dtmirizzi/Tesla-Model-3-Drive-Unit/ato/README.md

# M3DU logic board in atopile

An [atopile](https://atopile.io) port of the V3.2 logic board in
`../Design/M3DU_BoardV3_2`. It is the same board, checked pad by pad: the same
798 parts, designators, nets, BOM and hand-routed layout. It is organised into
modules, one per block of the schematic, and the three gate-driver phases share
one `GateDrivePhase` module. See [PLAN.md](PLAN.md) for details and next steps.

## Layout

```
ato.yaml                 atopile project (requires atopile ^0.15.9)
main.ato                 module M3DU: the blocks, power rails and nets between blocks
src/                     one module per schematic block (power/, gate_drive/, sensing/, ...)
parts/<KiCadLib>/        one atopile component per BOM line + its footprint/symbol
layouts/default/         the KiCad board atopile builds into (seeded from the original PCB)
lib/                     footprint + symbol libraries recovered from the KiCad design
reference/netlist.json   reference netlist extracted from the original PCB
reference/addresses.json designator -> atopile address (binds the layout)
tools/                   extraction, code generation, layout seeding and the equivalence check
```

## Build

```bash
uv venv -p 3.14 .venv && . .venv/bin/activate
uv pip install atopile==0.15.9 pandas xlrd

tools/port.sh            # extract -> generate -> seed layout -> ato build -> check
# or, once seeded:
ato build --no-standardize-designators
python tools/restore_layout.py  # put back attributes atopile 0.15.9 drops
python tools/check_netlist.py   # board vs KiCad V3.2: nets + layout
python tools/check_bom.py       # BOM vs the V3.2 JLC BOM
```

`main.ato`, `src/` and `parts/` are generated by `tools/gen_modules.py` (set
`FLAT=1` for a single flat module). The board stays bound to the layout through
the original designators.

`check_netlist.py` exits non-zero unless the built board matches the original:
the same references and pad geometry, the same pad-to-net partition, and every
footprint, track, via and zone in place.

Open `layouts/default/default.kicad_pcb` in KiCad 9 to view or edit the board.
After editing the layout, run `tools/port.sh --no-seed` so your edits are kept.
For now the original KiCad project is still the source of truth: `tools/port.sh`
and CI regenerate everything from it.
