dtmirizzi/Tesla-Model-3-Drive-Unit/ato/layouts/default/default.kicad_pcb

## KiCad design ato/layouts/default/default.kicad_pcb (2026-11-04)

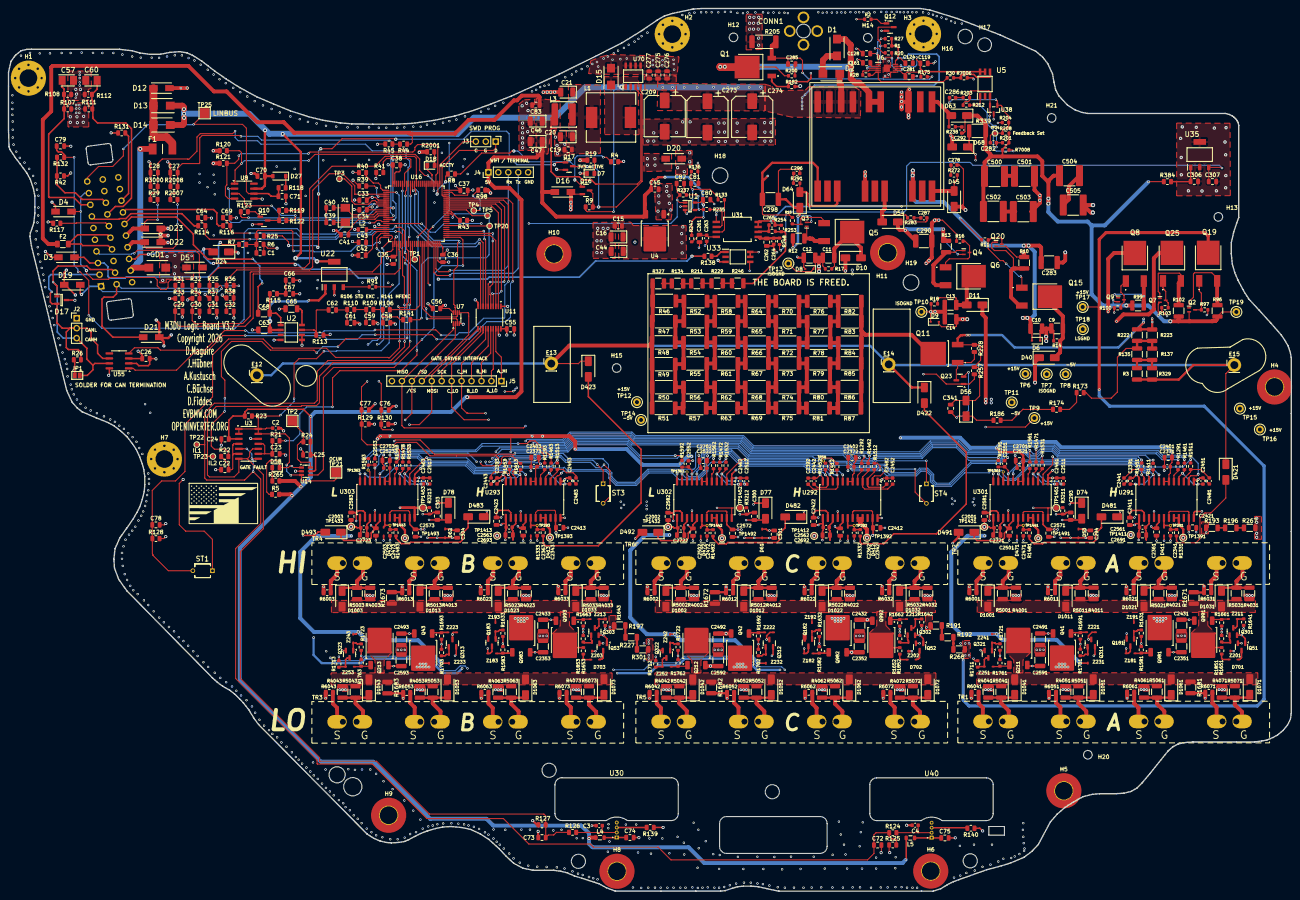
[picture p1: board default.kicad_pcb from above]

Board: 4 copper layers, 327.6 x 225.4 mm, 797 parts (1 on the bottom side), 394 nets.

Parts:
C1, C306: 1uF; C_0805_2012Metric__v3
C2: 10nF; C_0603_1608Metric__v3
C3, C4, C265: 10nF; C_0603_1608Metric
C9, C10, C11, C12, C13, C14: 2.2uF; C_1210_3225Metric
C15, C19, C22, C24, C25, C27, C28, C34, C35, C36, C56, C70: 1uF; C_0805_2012Metric__v2
C16, C20, C21, C44: 100uF 6.3V; CP_EIA-3528-15_AVX-H__v2
C23, C29, C30, C31, C32, C37, C38, C45, C55, C74, C75, C76, C77, C78, C79, C80, C119, C276, C277, C301, C304, C341, C2361, C2362, C2363, C2411, C2412, C2413, C2421, C2422, C2423, C2501, C2502, C2503, C2571, C2572, C2573, C2581: 1uF; C_0805_2012Metric
C26, C41, C42: 100nF; C_0805_2012Metric
C33, C43, C261: 10uF; C_0805_2012Metric
C39, C40: 22pF; C_0805_2012Metric
C46, C47: 100uF 6.3V; CP_EIA-3528-15_AVX-H
C57: 100uF 6.3V; CAPPM3528X210N
C58, C59, C61, C66, C67: 22nF; C_0805_2012Metric
C60: 100uF 6.3V; CAPPM3528X210N__v2
C62: 22nF; C_0805_2012Metric__v2
C63, C65: 10uF; C_1206_3216Metric__v2
C64, C69, C71, C72: 1nF; C_0805_2012Metric
C68: 10uF; C_1206_3216Metric
C73: 1nF; C_0805_2012Metric__v2
C81, C82: 100pF; C_0805_2012Metric
C83: 1nF; C_0805_2012Metric__v4
C124, C275: 0.1uF; C_0805_2012Metric
C128: 200pF; C_0805_2012Metric
C161: 47nF; C_0805_2012Metric
C209: 100uF 25V; CP_Elec_10x10
C262: 10uF; C_0805_2012Metric__v2
C263, C2001, C2002, C2003, C2371, C2372, C2373, C2521, C2522, C2523, C2561, C2562, C2563: 100nF; C_0603_1608Metric
C264: 100nF; C_0603_1608Metric__v2
C273, C274: 220uF 35V; CP_Elec_10x10
C278, C287, C292, C296, C2341, C2342, C2343, C2471, C2472, C2473: 82pF; C_0603_1608Metric
C281: 330pF; C_0805_2012Metric
C282: 10nF; C_0603_1608Metric__v2
C283, C290, C298: 3.3uF; C_1812_4532Metric
C285: 470pF; C_0805_2012Metric
C286: 22nF; C_0603_1608Metric__v2
C293, C294, C300, C303, C2582, C2583: 2.2uF; C_0805_2012Metric
C307: 10uF; C_0805_2012Metric__v3
C500, C501, C502, C503, C504, C505: 15uF; C_2220_5750Metric
C2351, C2352, C2353, C2431, C2432, C2433, C2491, C2492, C2493, C2591, C2592, C2593: 4.7uF; C_1210_3225Metric
C2391, C2392, C2393, C2451, C2452, C2453, C2461, C2462, C2463, C2481, C2482, C2483, C2511, C2512, C2513, C2551, C2552, C2553: 82pF; C_0603_1608Metric__v2
C2401, C2402, C2403, C2691, C2692, C2693, C2701, C2702, C2703, C2721, C2722, C2723: 4.7uF; C_0805_2012Metric
C2441, C2442, C2443: 470pF; C_0603_1608Metric__v2
CONN1: HV_Hvil; HV_HVIL
D1: 1N5819; DIOM5336X244N__v2
D2: 1N5935B; DIOM5336X244N__v2
D3, D4, D5, D19: SMAJ18CA; DIOM5127X229N
D6, D8: 5V1; D_SOD-323__v2
D7: 3V3 LED; LED_0805_2012Metric
D9: 5V1; D_SOD-323
D10, D40: SS35; D_SMA__v2
D11: SS35; D_SMA
D12: SMAJ18CA; DIONM5127X229N
D13, D14: SS54B; DIOM5336X244N
D15: SS54B; DIOM5336X244N__v2
D16, D22, D23: SMAJ7.0A; DIOM5026X229N
D17: ESDCAN01-2BLY; SOT95P255X150-3N
D18: LED; LED_0805_2012Metric
D20: SMAJ7.0A; DIOM5026X229N__v2
D21: SMAJ18CA; DIOM5127X229N__v2
D24: SMAJ18CA; D_SMA__v3
D27: 1N4148W; D_SOD-123
D45, D64: STPS2H100-Y; D_SMA__v2
D53, D61, D62: G1; D_SOD-323__v3
D54, D63: STPS2H100-Y; D_SMA
D56: 15V; D_SMA__v4
D58: LED; LED_0805_2012Metric__v2
D68: Zener 5V1; D_SMA
D74, D77, D78, D421, D422, D423: VN17; D_SMA
D411, D412, D413, D701, D702, D703: JV; D_SOD-323
D471, D472, D473: JV; D_SOD-323__v3
D481, D482, D483, D491, D492, D493: VN17; D_SMA__v2
D1001, D1002, D1003, D1011, D1012, D1013, D1021, D1022, D1023, D1031, D1032, D1033, D1041, D1042, D1043, D1051, D1052, D1053, D1061, D1062, D1063, D1071, D1072, D1073: 2H2; D_SMA
E12, E13, E14, E15: HV+; M3_HVPOS
F1: JFC2410-0500TS; FUSC6126X280N
F2: 1206L050/24WR; Fuse_1206_3216Metric
GD1: 2051-09-SM-RPLF; DIOM5336X244N
H1, H2, H3, H7: MountingHole_Pad; MountingHole_4.5mm_Pad_Via
H4, H5, H6, H8, H9, H10, H11: MountingHole_Pad; MountingHole_4.5mm_Pad_TopBottom
H12, H14, H15, H21: MountingHole; MountingHole_2.2mm_M2__v2
H13: MountingHole; MountingHole_2.2mm_M2__v3
H16: MountingHole; MountingHole_3.7mm
H17: MountingHole; MountingHole_3.5mm
H18, H19: MountingHole; MountingHole_4mm
H20: MountingHole; MountingHole_2.2mm_M2
J1: Conn_01x30_Male; M3DU_MAINCONN
J2: CAN MON; PinHeader_1x03_P2.54mm_Vertical
J3: M032.54MM; PinHeader_1x03_P2.54mm_Vertical
J4: WiFi Serial Interface; PinHeader_1x05_P2.54mm_Vertical
J5: Conn_01x12_Socket; PinSocket_1x12_P2.54mm_Vertical
JP1: SolderJumper_2_Open; SolderJumper-2_P1.3mm_Open_Pad1.0x1.5mm
L1: 68uH; L_12x12mm_H8mm
L2, L4, L5: 10uH; L_0805_2012Metric
L3: 3uH; L_APV_ANR6020
Q1: IPD50N06S409ATMA2
Q2, Q3, Q4, Q7, Q9, Q20: BC857BT-7-F; SOT50P160X90-3N
Q5, Q6, Q15: NJVMJD127T4G; NVD5117PLT4GVF01__v2
Q8, Q19, Q25: NJVMJD127T4G; NVD5117PLT4GVF01
Q10, Q12: MMBT3904; SOT-23
Q11: FGD3N60LSDTM
Q16, Q17: MMBT3904; SOT-23__v3
Q23: BSS84W; SOT-23__v2
Q41, Q42, Q43, Q981, Q982, Q983: 45P4LLF6; TO-252-2
Q51, Q52, Q53: SG NMOS D; SOT-23
Q181, Q182, Q183: BSS84AK; SOT-23__v2
Q211, Q212, Q213, Q991, Q992, Q993: 3N0408; TO-252-2
Q301, Q302, Q303: BSS138BK; SOT-23__v2
Q311, Q312, Q313: BSS84AK; SOT-23
Q321, Q322, Q323: BSS138BK; SOT-23
R1, R133, R136, R235, R237: 10K; R_0603_1608Metric
R2: 3K3; R_0603_1608Metric
R3, R135, R137, R222, R223, R329: 82K; R_1210_3225Metric
R4: 10K; R_0805_2012Metric__v6
R5: 10K; R_0805_2012Metric__v9
R6: 1K5; R_0805_2012Metric__v3
R7: 4K7; R_0805_2012Metric__v3
R8, R25: 10K; R_0805_2012Metric__v3
R9: 27K; R_0805_2012Metric__v4
R10, R13, R99: 4R99; R_1210_3225Metric
R11, R16, R97, R100, R103: 22K; R_0603_1608Metric
R12, R96, R102: 4R99; R_1210_3225Metric__v2
R14, R17, R18: 4K7; R_0603_1608Metric
R15: 22K; R_0603_1608Metric__v2
R19: 680R; R_0805_2012Metric__v2
R20: 4R7; R_0603_1608Metric
R21, R22, R113, R114, R115, R116, R119, R128, R129, R130: 10K; R_0805_2012Metric__v2
R23, R24, R31, R32, R35, R36, R41: 4K7; R_0805_2012Metric__v2
R26: 120R; R_0805_2012Metric__v2
R27: 300K; R_0603_1608Metric
R28: 33.2K; R_0603_1608Metric__v2
R29, R39, R40, R43, R118, R123, R131, R132, R265, R2007, R2008, R3000: 1K; R_0805_2012Metric__v2
R30: 18K; R_0603_1608Metric
R33, R34, R37, R38: 1K5; R_0805_2012Metric__v2
R42, R44: 47K; R_0805_2012Metric__v2
R45, R122: 3K3; R_0805_2012Metric__v2
R46, R51, R56, R61, R66, R71, R76, R81, R82, R83, R84, R85, R86, R87: 3K9; R_2512_6332Metric
R47, R48, R49, R50, R52, R53, R54, R55, R57, R58, R59, R60, R62, R63, R64, R65, R67, R68, R69, R70, R72, R73, R74, R75, R77, R78, R79, R80: 3K9; R_2512_6332Metric__v2
R91: 1K; R_0603_1608Metric
R98: 1K; R_0805_2012Metric__v3
R106: 3K9; R_0805_2012Metric__v7
R107, R108, R112: 220R; R_0805_2012Metric__v2
R109, R110: 1K8; R_0805_2012Metric__v2
R111: 220R; R_0805_2012Metric
R117: 0R; R_0805_2012Metric__v2
R120, R121, R138: 2K2; R_0805_2012Metric__v2
R124, R126: 3K6; R_0805_2012Metric__v2
R125, R127: 6K2; R_0805_2012Metric__v2
R134, R211, R229, R246, R327: 75K; R_1210_3225Metric
R139, R140: 10k; R_0805_2012Metric__v5
R141: 3K9; R_0805_2012Metric__v8
R173, R174, R186: 50K; R_0805_2012Metric__v4
R175, R1331, R1332, R1333, R1411, R1412, R1413, R1461, R1462, R1463, R1471, R1472, R1473, R1481, R1482, R1483, R7006: 1k; R_0603_1608Metric
R182: 100K; R_0603_1608Metric__v2
R191, R192, R193, R196, R197, R227, R267, R268, R301: 1M; R_1206_3216Metric
R200: 20R; R_0603_1608Metric__v2
R201: 35K6; R_0603_1608Metric
R203, R212: 25K; R_0603_1608Metric
R204: 5K6; R_0603_1608Metric
R205: 0.01R; R_2512_6332Metric_Pad1.40x3.35mm_HandSolder
R208: 39K; R_0603_1608Metric
R228, R257: 100K; R_0805_2012Metric__v2
R238: 80.6R; R_0603_1608Metric__v2
R247, R248: 10R; R_0603_1608Metric
R253: 39R; R_0603_1608Metric
R254: 1K6; R_0603_1608Metric
R272, R283, R291: 80.6R; R_0603_1608Metric
R339: 4K7; R_1812_4532Metric
R384: 0R; R_0805_2012Metric__v4
R1291, R1292, R1293, R1561, R1562, R1563: 680; R_0603_1608Metric
R1451, R1452, R1453, R1511, R1512, R1513, R1531, R1532, R1533, R1641, R1642, R1643, R1711, R1712, R1713: 100; R_0603_1608Metric
R1581, R1582, R1583, R1631, R1632, R1633, R1651, R1652, R1661, R1662, R1663, R1691, R1692, R1693, R1701, R1702, R1703, R1761, R1762, R1763, R1853: 27K; R_0603_1608Metric
R1591, R1592, R1593: 200; R_0603_1608Metric
R1653, R1851, R1852: 470; R_0603_1608Metric
R1671, R1672, R1673: 4K7; R_1210_3225Metric__v2
R1681, R1682, R1683: 4K7; R_1210_3225Metric
R1721, R1722, R1723: 27K; R_0603_1608Metric__v3
R2001: 330R; R_0805_2012Metric__v2
R3211, R3212, R3213: 0R; R_0603_1608Metric
R4001, R4002, R4003, R4011, R4012, R4013, R4021, R4022, R4023, R4031, R4032, R4033, R4041, R4042, R4043, R4051, R4052, R4053, R4061, R4062, R4063, R4071, R4072, R4073: 12; R_1210_3225Metric
R5001, R5002, R5003, R5011, R5012, R5013, R5021, R5022, R5023, R5031, R5032, R5033, R5041, R5042, R5043, R5051, R5052, R5053, R5061, R5062, R5063, R5071, R5072, R5073: 10; R_1210_3225Metric
R6001, R6002, R6003, R6011, R6012, R6013, R6021, R6022, R6023, R6031, R6032, R6033, R6041, R6042, R6043, R6051, R6052, R6053, R6061, R6062, R6063, R6071, R6072, R6073: 0.56R; R_0805_2012Metric
R7008: 2K; R_0603_1608Metric
ST1, ST3, ST4: Thermistor; B59100C0140A070
T1: TDK_VGT; VGT22EPC-200S6A12
TP1, TP3, TP4, TP5, TP22, TP23, TP24: TestPoint; TestPoint_Pad_D1.0mm
TP2, TP21, TP25: TestPoint; TestPoint_Pad_2.5x2.5mm
TP6, TP7, TP8, TP9, TP11, TP12, TP13, TP14, TP15, TP16, TP17, TP18, TP19: TestPoint; TestPoint_Keystone_5000-5004_Miniature
TP10: GND_ISO_C; TestPoint_Keystone_5000-5004_Miniature
TP20: TestPoint_Pad_D1.0mm
TP58, TP291, TP292, TP293, TP1361, TP1362, TP1363, TP1441, TP1442, TP1443: TestPoint; TestPoint_Via
TP1391, TP1392, TP1393, TP1411, TP1412, TP1413, TP1431, TP1432, TP1433, TP1451, TP1452, TP1453, TP1491, TP1492, TP1493: TestPoint; TestPoint_Pad_D1.5mm
TR1, TR2, TR3, TR4, TR5: M3DU_MOSFETS; M3DU_Mosfets
TR6: CH1234; M3DU_Mosfets
U1: OPA320AIDBVR; SOT95P280X145-5N
U2: TDA2822D013TR; SOIC127P600X175-8N
U3: LM2901; SOIC-14_3.9x8.7mm_P1.27mm
U4: LD1086DT33TR; TO-252-2
U5, U33: ACPL-M49T-000E; SOIC127P700X260-6N
U6: TPS40210DGQR; SOP50P490X110-11N
U7: 74LVC3G17; VSSOP-8_2.3x2mm_P0.5mm
U8: TJA1021T; SOIC-8_3.9x4.9mm_P1.27mm
U11: SN74LVC245APW; TSSOP-20_4.4x6.5mm_P0.65mm
U14: 74LVC1G10; SOT-23-6
U16: STM32F103VCTx; LQFP-100_14x14mm_P0.5mm
U22: NCV8452STT3G; SOT230P700X180-4N__v2
U30, U40: MLX91209LVA-CAA-000-SP; SIP_4L_VA
U31: ACPL-C87A; SSO-8_6.8x5.9mm_P1.27mm_Clearance8mm
U35: TLE4264G; SOT230P700X180-4N
U38: TL432AQDBZRQ1; SOT95P237X112-3N
U55: SN65HVD230; SOIC-8_3.9x4.9mm_P1.27mm__v2
U70: XL1509-5.0E1; SOIC127P600X175-8N
U291, U302: STGAP1AS; SOIC-24W_7.5x15.4mm_P1.27mm
U292: STGAP1AS; SOIC-24W_7.5x15.4mm_P1.27mm__v2
U293, U301, U303: STGAP1AS; SOIC-24W_7.5x15.4mm_P1.27mm__v3
X1: X50328MSB2GI; Crystal_SMD_5032-2Pin_5.0x3.2mm
Z181, Z182, Z183, Z201, Z202, Z203, Z211, Z212, Z213, Z221, Z222, Z223, Z251, Z252, Z253: 8.2V; D_SOD-323
Z191, Z192, Z193, Z241, Z242, Z243: 8.2V; D_SOD-323__v3
Z231, Z232, Z233: 8.2V; D_SOD-323__v2

Connections:
+3.3VA: C42.2, C43.2, L2.2, U16.21, U16.22
+3V3: C15.1, C16.1, C26.1, C33.2, C34.1, C35.1, C36.1, C37.1, C38.1, C44.1, C55.1, C56.1, C2371.2, C2372.2, C2373.2, C2401.2, C2402.2, C2403.2, C2521.2, C2522.2, C2523.2, C2701.2, C2702.2, C2703.2, D20.1, L2.1, R19.1, R39.1, R40.1, R43.1, R98.1, R107.2, R111.2, R120.1, R121.1, R131.1, R2001.1, ST1.1, ST3.1, ST4.1, U4.2, U7.8, U11.1, U11.20, U16.6, U16.11, U16.28, U16.50, U16.75, U16.100, U55.3, U291.6, U291.7, U292.6, U292.7, U293.6, U293.7, U301.6, U301.7, U302.6, U302.7, U303.6, U303.7
+5V: C24.1, C25.1, C45.1, C46.1, C47.1, C80.1, C83.1, D16.1, F2.2, J4.1, L3.2, L4.1, L5.1, R5.1, R23.2, R24.2, R44.1, R247.1, R265.2, U1.5, U3.3, U4.3, U14.5, U70.3
+5VP: C307.1, R248.2, U35.3
+12P: F1.1, GD1.2, J1.22
+12V: C70.1, C124.1, C209.1, C273.1, C274.1, C275.1, C276.1, C277.1, D2.2, D13.1, D14.1, D27.2, R1.2, R9.1, R27.1, R119.1, T1.6, T1.7, T1.8, T1.9, U6.10, U8.7, U22.4, U70.1
+15VH: C341.1, D56.1, Q23.2, R186.1, U33.5, U33.6
/5Vunfil: C19.1, C20.1, C21.1, L1.2, L3.1
/ASC_L: R3211.1, R3212.1, R3213.1, TP1451.1, TP1452.1, TP1453.1, U301.24, U302.24, U303.24
/CANH: D17.1, J1.12, J2.3, JP1.2, U55.7
/CANL: D17.2, J1.2, J2.2, R26.2, U55.6
/GATE_CS: J5.10, R1461.2, R1462.2, R1463.2, R1471.2, R1472.2, R1473.2, U7.2
/GATE_DIAG: D58.1, R5.2, TP1361.1, TP1362.1, TP1363.1, U14.1, U291.10, U292.10, U293.10, U301.10, U302.10, U303.10
/GATE_SD: J5.9, R1451.2, R1452.2, R1453.2, TP58.1, U7.5
/GATE_SPI_MISO: J5.11, U7.1, U291.2
/GATE_SPI_MOSI: J5.8, R1533.2, U11.11
/GATE_SPI_SCK: J5.7, R1291.2, R1292.2, R1293.2, R1561.2, R1562.2, R1563.2, U11.12
/GND_ISO_A: C9.1, C10.2, C2341.2, C2351.2, C2361.2, C2411.2, C2421.2, C2431.1, C2561.1, C2691.1, D6.1, D411.2, D481.1, R14.2, R1671.2, R6001.1, R6011.1, R6021.1, R6031.1, TP7.1, TP1411.1, U291.13, U291.16, U291.24
/GND_ISO_B: C11.1, C12.2, C2343.2, C2353.2, C2363.2, C2413.2, C2423.2, C2433.1, C2563.1, C2693.1, D8.1, D413.2, D483.1, R17.2, R1673.2, R6003.1, R6013.1, R6023.1, R6033.1, TP13.1, TP1413.1, U293.13, U293.16, U293.24
/GND_ISO_C: C13.1, C14.2, C2342.2, C2352.2, C2362.2, C2412.2, C2422.2, C2432.1, C2562.1, C2692.1, D9.1, D412.2, D482.1, R18.2, R1672.2, R6002.1, R6012.1, R6022.1, R6032.1, TP10.1, TP1412.1, U292.13, U292.16, U292.24
/HV+: D421.1, D422.1, D423.1, E12.1, E13.1, E14.1, E15.1, R3.2, R46.2, R47.2, R48.2, R49.2, R50.2, R51.2, R327.1, R329.2
/LIN_BUS: C71.1, J1.10, R118.2, TP25.1, U8.6
/PWMA_HI: J5.1, R1411.2, U11.18
/PWMA_LO: J5.2, R1591.2, U11.17
/PWMB_HI: J5.3, R1413.2, U11.16
/PWMB_LO: J5.4, R1593.2, U11.15
/PWMC_HI: J5.5, R1412.2, U11.14
/PWMC_LO: J5.6, R1592.2, U11.13
/SDI_A: R1531.2, U292.2
/SDI_C: R1532.2, U293.2
/VH_HS_A: C2351.1, C2361.1, D40.1, Q181.2, Q981.3, R1581.2, R1631.1, TP6.1, U291.17
/VH_HS_B: C2353.1, C2363.1, D10.1, Q183.2, Q983.3, R1583.2, R1633.1, TP12.1, U293.17
/VH_HS_C: C2352.1, C2362.1, D11.1, Q182.2, Q982.3, R1582.2, R1632.1, TP9.1, U292.17
/VH_LS: D491.2, D492.2, D493.2
/VH_LS_A: C2491.1, C2501.1, D74.1, D491.1, Q41.3, Q311.2, R1691.2, R1701.1, U301.17
/VH_LS_A_PRI: C293.1, D74.2, Q19.2, TP17.1
/VH_LS_B: C2493.1, C2503.1, D78.1, D493.1, Q43.3, Q313.2, R1693.2, R1703.1, U303.17
/VH_LS_B_PRI: C303.1, D78.2, Q25.2, TP15.1
/VH_LS_C: C2492.1, C2502.1, D77.1, D492.1, Q42.3, Q312.2, R1692.2, R1702.1, U302.17
/VH_LS_C_PRI: C300.1, D77.2, Q8.2, TP16.1
/VL_HS_A: C10.1, C283.2, C2411.1, C2421.1, C2431.2, D6.2, Q51.1, Q301.2, Q991.3, R11.2, R1651.2, R1661.1, T1.16, TP8.1, U291.14, U291.19, U291.23
/VL_HS_B: C12.1, C298.2, C2413.1, C2423.1, C2433.2, D8.2, Q53.1, Q303.2, Q993.3, R15.2, R1663.1, R1853.2, T1.10, TP14.1, U293.14, U293.19, U293.23
/VL_HS_C: C14.1, C290.2, C2412.1, C2422.1, C2432.2, D9.2, Q52.1, Q302.2, Q992.3, R16.2, R1652.2, R1662.1, T1.13, TP11.1, U292.14, U292.19, U292.23
ACCEL1: D23.1, J1.25, R29.2
ACCEL2: D22.1, J1.24, R2007.2
ACT_DISCH: D24.2, J1.23, R138.2
BMS_IN: TP5.1, U16.65
BRAKE: D21.1, J1.11, R36.2
BRAKE_IN: C32.1, R36.1, R38.2, U16.3
CAN_RX: U16.70, U55.4
CAN_TX: U16.71, U55.1
COSA: C57.1, J1.8, R107.1, R108.2
COSB: J1.27, R116.2
DCSW_OUT: TP3.1, U16.7
DESAT: R98.2, TP4.1, U16.66
EMCYSTOP_IN: R43.2, U16.64
ENC_A: C64.1, R114.1, U16.31
ENC_B: C69.1, R116.1, U16.32
EXCA: C68.2, J1.26
EXCB: J1.16, R117.1
EXC_OUT: R106.2, U16.83
FORW_IN: D4.1, J1.9, R31.2
FWD_IN: C29.1, R31.1, R33.2, U16.29
GATE PSU EN: R2.1, R91.2, U16.44
GATEDRV_CS: U7.6, U16.41
GATEDRV_SD: U7.3, U16.42
GND: C1.2, C2.2, C3.2, C4.2, C15.2, C16.2, C19.2, C20.2, C21.2, C22.2, C23.2, C24.2, C25.2, C26.2, C27.2, C28.2, C29.2, C30.2, C31.2, C32.2, C33.1, C34.2, C35.2, C36.2, C37.2, C38.2, C39.1, C40.1, C41.1, C42.1, C43.1, C44.2, C45.2, C46.2, C47.2, C55.2, C56.2, C57.2, C58.2, C59.2, C60.2, C61.2, C63.1, C64.2, C65.1, C66.2, C67.2, C69.2, C70.2, C71.2, C72.2, C73.2, C74.2, C75.2, C76.2, C77.2, C78.2, C79.2, C80.2, C81.2, C83.2, C119.2, C124.2, C128.2, C161.2, C209.2, C261.2, C263.1, C273.2, C274.2, C275.2, C276.2, C277.2, C281.2, C2371.1, C2372.1, C2373.1, C2391.2, C2392.2, C2393.2, C2401.1, C2402.1, C2403.1, C2441.2, C2442.2, C2443.2, C2451.2, C2452.2, C2453.2, C2461.2, C2462.2, C2463.2, C2481.2, C2482.2, C2483.2, C2511.2, C2512.2, C2513.2, C2521.1, C2522.1, C2523.1, C2551.2, C2552.2, C2553.2, C2701.1, C2702.1, C2703.1, D3.2, D4.2, D5.2, D7.1, D12.2, D15.2, D16.2, D17.3, D19.2, D20.2, D21.2, D22.2, D23.2, D24.1, GD1.1, H1.1, H2.1, H3.1, H7.1, J1.5, J1.6, J1.13, J2.1, J3.2, J4.5, Q10.2, Q12.2, Q16.2, Q17.2, R4.2, R6.1, R33.1, R34.1, R37.1, R38.1, R41.1, R42.1, R45.2, R108.1, R112.1, R113.1, R117.2, R125.1, R127.1, R128.2, R129.2, R130.2, R136.2, R139.1, R140.1, R182.2, R205.2, R2008.1, R3000.1, R7006.2, U1.2, U2.4, U2.5, U2.6, U3.12, U4.1, U6.6, U6.11, U7.4, U8.5, U11.10, U11.19, U14.2, U16.10, U16.19, U16.20, U16.27, U16.49, U16.74, U16.99, U22.2, U30.4, U31.5, U33.3, U40.4, U55.2, U55.8, U70.5, U70.6, U70.7, U70.8, U291.1, U291.12, U292.1, U292.12, U293.1, U293.12, U301.1, U301.12, U302.1, U302.12, U303.1, U303.12
HFEXC: R141.2, U16.63
HV-: C262.1, C264.2, C265.2, C293.2, C294.2, C300.2, C301.2, C303.2, C304.2, C306.2, C307.2, C341.2, C2001.1, C2002.1, C2003.1, C2471.2, C2472.2, C2473.2, C2491.2, C2492.2, C2493.2, C2501.2, C2502.2, C2503.2, C2571.2, C2572.2, C2573.2, C2581.2, C2582.2, C2583.2, C2591.1, C2592.1, C2593.1, C2721.1, C2722.1, C2723.1, D53.1, D56.2, D61.1, D62.1, D68.1, D471.2, D472.2, D473.2, Q11.3, R222.1, R223.1, R228.1, R254.2, R257.1, R267.2, R268.2, R301.2, R339.1, R1681.2, R1682.2, R1683.2, R3211.2, R3212.2, R3213.2, R6041.1, R6042.1, R6043.1, R6051.1, R6052.1, R6053.1, R6061.1, R6062.1, R6063.1, R6071.1, R6072.1, R6073.1, TP1431.1, TP1432.1, TP1433.1, U31.3, U31.4, U35.2, U35.4, U301.13, U301.16, U302.13, U302.16, U303.13, U303.16
IL1: C72.1, R124.1, R125.2, TP22.1, U3.5, U3.8, U16.30
IL2: C73.1, R126.1, R127.2, TP23.1, U3.7, U3.10, U16.35
LED_OUT: D18.1, U16.80
LIN_NSLP: U8.2, U16.9
LIN_Rx: R120.2, U8.1, U16.79
LIN_Tx: R121.2, U8.4, U16.78
LIN_WAKE: R123.1, U16.8
LS_+V: C292.1, C500.1, C502.1, C504.1, D63.1, Q2.2, Q7.2, Q9.2, R96.1, R99.1, R102.1, R201.2, R208.2, R339.2, R384.1, R7008.1, TP19.1
LS_GND: C294.1, C301.1, C304.1, C501.2, C503.2, C505.2, C2571.1, C2572.1, C2573.1, C2581.1, C2582.1, C2583.1, C2591.2, C2592.2, C2593.2, D53.2, D61.2, D62.2, D68.2, Q211.3, Q212.3, Q213.3, Q321.2, Q322.2, Q323.2, R97.2, R100.2, R103.2, R204.1, R1721.2, R1722.2, R1723.2, R1761.1, R1762.1, R1763.1, T1.3, TP18.1, U38.3, U301.14, U301.19, U301.23, U302.14, U302.19, U302.23, U303.14, U303.19, U303.23
MAIN_PSU_EN: R8.2, U16.77
MOT_NTC1: J1.28, R131.2
MOT_NTC2: J1.18, R42.2, R132.2
MPROT_IN: R39.2, U16.4
unnamed: C58.1, R106.1, R109.2, R141.1
unnamed: C59.1, R109.1, R110.2
unnamed: C61.1, C62.1, R110.1
unnamed: C66.1, C67.1, R115.1
unnamed: C278.1, R272.1
unnamed: C285.1, R200.2
unnamed: C286.2, R203.1
unnamed: C287.1, R283.1
unnamed: C292.2, R238.2
unnamed: C296.1, R291.1
unnamed: C500.2, C501.1
unnamed: C502.2, C503.1
unnamed: C504.2, C505.1
unnamed: D1.2, Q1.2, R200.1, T1.4, T1.5
unnamed: D1.1, D2.1
unnamed: D7.2, R19.2
unnamed: C11.2, D10.2, Q5.2, R17.1
unnamed: C13.2, D11.2, Q6.2, R18.1
unnamed: D12.1, D13.2, D14.2, F1.2
unnamed: D18.2, R2001.2
unnamed: D27.1, R118.1
unnamed: C9.2, D40.2, Q15.2, R14.1
unnamed: D45.2, R272.2, T1.18
unnamed: C278.2, C283.1, D45.1, Q20.2, R10.1
unnamed: D54.2, R283.2, T1.15
unnamed: C287.2, C290.1, D54.1, Q4.2, R13.1
unnamed: D58.2, R265.1
unnamed: D63.2, R238.1, T1.1
unnamed: D64.2, R291.2, T1.12
unnamed: C296.2, C298.1, D64.1, Q3.2, R12.1
unnamed: C2341.1, D411.1, R1331.1, TP291.1, U291.18
unnamed: C2342.1, D412.1, R1332.1, TP292.1, U292.18
unnamed: C2343.1, D413.1, R1333.1, TP293.1, U293.18
unnamed: D421.2, R1331.2
unnamed: D422.2, R1332.2
unnamed: D423.2, R1333.2
unnamed: C2471.1, D471.1, R1481.1, TP1441.1, U301.18
unnamed: C2472.1, D472.1, R1482.1, TP1442.1, U302.18
unnamed: C2473.1, D473.1, R1483.1, TP1443.1, U303.18
unnamed: D481.2, R1481.2
unnamed: D482.2, R1482.2
unnamed: D483.2, R1483.2
unnamed: D701.2, R1851.1
unnamed: D701.1, Q51.3
unnamed: D702.2, R1852.1
unnamed: D702.1, Q52.3
unnamed: D703.2, R1653.1
unnamed: D703.1, Q53.3
unnamed: D1001.2, D1011.2, D1021.2, D1031.2, Q991.2, R1671.1, R1851.2, R5001.1, R5011.1, R5021.1, R5031.1
unnamed: D1001.1, R4001.2, R5001.2, TR2.2
unnamed: D1002.2, D1012.2, D1022.2, D1032.2, Q992.2, R1672.1, R1852.2, R5002.1, R5012.1, R5022.1, R5032.1
unnamed: D1002.1, R4002.2, R5002.2, TR6.2
unnamed: D1003.2, D1013.2, D1023.2, D1033.2, Q993.2, R1653.2, R1673.1, R5003.1, R5013.1, R5023.1, R5033.1
unnamed: D1003.1, R4003.2, R5003.2, TR4.2
unnamed: D1011.1, R4011.2, R5011.2, TR2.4
unnamed: D1012.1, R4012.2, R5012.2, TR6.4
unnamed: D1013.1, R4013.2, R5013.2, TR4.4
unnamed: D1021.1, R4021.2, R5021.2, TR2.6
unnamed: D1022.1, R4022.2, R5022.2, TR6.6
unnamed: D1023.1, R4023.2, R5023.2, TR4.6
unnamed: D1031.1, R4031.2, R5031.2, TR2.8
unnamed: D1032.1, R4032.2, R5032.2, TR6.8
unnamed: D1033.1, R4033.2, R5033.2, TR4.8
unnamed: D1041.2, D1051.2, D1061.2, D1071.2, Q211.2, R1681.1, R5041.1, R5051.1, R5061.1, R5071.1
unnamed: D1041.1, R4041.2, R5041.2, TR1.2
unnamed: D1042.2, D1052.2, D1062.2, D1072.2, Q212.2, R1682.1, R5042.1, R5052.1, R5062.1, R5072.1
unnamed: D1042.1, R4042.2, R5042.2, TR5.2
unnamed: D1043.2, D1053.2, D1063.2, D1073.2, Q213.2, R1683.1, R5043.1, R5053.1, R5063.1, R5073.1
unnamed: D1043.1, R4043.2, R5043.2, TR3.2
unnamed: D1051.1, R4051.2, R5051.2, TR1.4
unnamed: D1052.1, R4052.2, R5052.2, TR5.4
unnamed: D1053.1, R4053.2, R5053.2, TR3.4
unnamed: D1061.1, R4061.2, R5061.2, TR1.6
unnamed: D1062.1, R4062.2, R5062.2, TR5.6
unnamed: D1063.1, R4063.2, R5063.2, TR3.6
unnamed: D1071.1, R4071.2, R5071.2, TR1.8
unnamed: D1072.1, R4072.2, R5072.2, TR5.8
unnamed: D1073.1, R4073.2, R5073.2, TR3.8
unnamed: F2.1, J1.14, J1.15
unnamed: JP1.1, R26.1
unnamed: Q1.1, R20.1, R182.1
unnamed: C285.2, Q1.3, R175.2, R205.1
unnamed: Q3.1, Q5.3, R12.2
unnamed: Q3.3, Q5.1, R15.1
unnamed: Q4.1, Q6.3, R13.2
unnamed: Q4.3, Q6.1, R16.1
unnamed: Q8.1, Q9.3, R100.1
unnamed: Q8.3, Q9.1, R99.2
unnamed: Q10.1, R123.2
unnamed: Q10.3, R119.2, R122.1
unnamed: Q11.2, R82.1, R83.1, R84.1, R85.1, R86.1, R87.1
unnamed: Q11.1, Q23.3, R228.2
unnamed: Q12.1, R2.2
unnamed: Q12.3, R1.1, U6.3
unnamed: Q15.1, Q20.3, R11.1
unnamed: Q15.3, Q20.1, R10.2
unnamed: Q16.1, R4.1, R8.1
unnamed: Q16.3, Q17.3, R9.2, U70.4
unnamed: Q17.1, R25.1
unnamed: Q2.3, Q19.1, R97.1
unnamed: Q2.1, Q19.3, R96.2
unnamed: Q23.1, R257.2, U33.4
unnamed: Q7.3, Q25.1, R103.1
unnamed: Q7.1, Q25.3, R102.2
unnamed: Q41.2, R4041.1, R4051.1, R4061.1, R4071.1
unnamed: Q41.1, R1691.1, Z221.1
unnamed: Q42.2, R4042.1, R4052.1, R4062.1, R4072.1
unnamed: Q42.1, R1692.1, Z222.1
unnamed: Q43.2, R4043.1, R4053.1, R4063.1, R4073.1
unnamed: Q43.1, R1693.1, Z223.1
unnamed: Q51.2, R193.1
unnamed: Q52.2, R191.1
unnamed: Q53.2, R197.1
unnamed: Q181.3, R1641.1, Z181.2
unnamed: Q181.1, R1631.2, Z191.1
unnamed: Q182.3, R1642.1, Z182.2
unnamed: Q182.1, R1632.2, Z192.1
unnamed: Q183.3, R1643.1, Z183.2
unnamed: Q183.1, R1633.2, Z193.1
unnamed: Q211.1, R1761.2, Z251.2
unnamed: Q212.1, R1762.2, Z252.2
unnamed: Q213.1, R1763.2, Z253.2
unnamed: Q301.3, R1641.2, Z211.1
unnamed: Q301.1, R1651.1, Z201.2
unnamed: Q302.3, R1642.2, Z212.1
unnamed: Q302.1, R1652.1, Z202.2
unnamed: Q303.3, R1643.2, Z213.1
unnamed: Q303.1, R1853.1, Z203.2
unnamed: Q311.3, R1711.1, Z221.2
unnamed: Q311.1, R1701.2, Z231.1
unnamed: Q312.3, R1712.1, Z222.2
unnamed: Q312.1, R1702.2, Z232.1
unnamed: Q313.3, R1713.1, Z223.2
unnamed: Q313.1, R1703.2, Z233.1
unnamed: Q321.3, R1711.2, Z251.1
unnamed: Q321.1, R1721.1, Z241.2
unnamed: Q322.3, R1712.2, Z252.1
unnamed: Q322.1, R1722.1, Z242.2
unnamed: Q323.3, R1713.2, Z253.1
unnamed: Q323.1, R1723.1, Z243.2
unnamed: Q981.2, R4001.1, R4011.1, R4021.1, R4031.1
unnamed: Q981.1, R1581.1, Z181.1
unnamed: Q982.2, R4002.1, R4012.1, R4022.1, R4032.1
unnamed: Q982.1, R1582.1, Z182.1
unnamed: Q983.2, R4003.1, R4013.1, R4023.1, R4033.1
unnamed: Q983.1, R1583.1, Z183.1
unnamed: Q991.1, R1661.2, Z211.2
unnamed: Q992.1, R1662.2, Z212.2
unnamed: Q993.1, R1663.2, Z213.2
unnamed: R24.1, TP2.1, U14.6
unnamed: R46.1, R47.1, R48.1, R49.1, R50.1, R51.1, R52.2, R53.2, R54.2, R55.2, R56.2, R57.2
unnamed: R52.1, R53.1, R54.1, R55.1, R56.1, R57.1, R58.2, R59.2, R60.2, R61.2, R62.2, R63.2
unnamed: R58.1, R59.1, R60.1, R61.1, R62.1, R63.1, R64.2, R65.2, R66.2, R67.2, R68.2, R69.2
unnamed: R64.1, R65.1, R66.1, R67.1, R68.1, R69.1, R70.2, R71.2, R72.2, R73.2, R74.2, R75.2
unnamed: R70.1, R71.1, R72.1, R73.1, R74.1, R75.1, R76.2, R77.2, R78.2, R79.2, R80.2, R81.2
unnamed: R76.1, R77.1, R78.1, R79.1, R80.1, R81.1, R82.2, R83.2, R84.2, R85.2, R86.2, R87.2
unnamed: R134.1, R327.2
unnamed: R134.2, R211.1
unnamed: R135.1, R137.1, R173.2, R222.2, R223.2
unnamed: R3.1, R135.2, R137.2, R329.1
unnamed: R173.1, R174.2
unnamed: R174.1, R186.2
unnamed: R191.2, R192.1
unnamed: R192.2, R268.1
unnamed: R193.2, R196.1
unnamed: R196.2, R267.1
unnamed: R197.2, R227.1
unnamed: R211.2, R229.2
unnamed: R227.2, R301.1
unnamed: R229.1, R246.2
unnamed: R246.1, R253.2, R254.1
unnamed: R6041.2, TR1.1
unnamed: R6051.2, TR1.3
unnamed: R6061.2, TR1.5
unnamed: R6071.2, TR1.7
unnamed: R6001.2, TR2.1
unnamed: R6011.2, TR2.3
unnamed: R6021.2, TR2.5
unnamed: R6031.2, TR2.7
unnamed: R6043.2, TR3.1
unnamed: R6053.2, TR3.3
unnamed: R6063.2, TR3.5
unnamed: R6073.2, TR3.7
unnamed: R6003.2, TR4.1
unnamed: R6013.2, TR4.3
unnamed: R6023.2, TR4.5
unnamed: R6033.2, TR4.7
unnamed: R6042.2, TR5.1
unnamed: R6052.2, TR5.3
unnamed: R6062.2, TR5.5
unnamed: R6072.2, TR5.7
unnamed: R6002.2, TR6.1
unnamed: R6012.2, TR6.3
unnamed: R6022.2, TR6.5
unnamed: R6032.2, TR6.7
unnamed: C81.1, R133.1, R136.1, U1.3
unnamed: C82.2, R235.1, R237.2, U1.4
unnamed: C62.2, R113.2, U2.7
unnamed: C65.2, U2.8
unnamed: C68.1, R115.2, U2.1
unnamed: C63.2, U2.2, U22.1
unnamed: C22.1, R22.1, U3.4, U3.6
unnamed: C23.1, R21.1, U3.9, U3.11
unnamed: R212.1, R7008.2, U5.1
unnamed: R30.2, R7006.1, U5.4
unnamed: C119.1, U5.5, U5.6, U6.9
unnamed: R28.1, U6.4
unnamed: R28.2, R30.1, U6.5
unnamed: R20.2, U6.8
unnamed: C281.1, R175.1, U6.7
unnamed: C128.1, R27.2, U6.1
unnamed: C161.1, U6.2
unnamed: R122.2, U8.3
unnamed: R41.2, U16.94
unnamed: C41.2, U16.14
unnamed: C40.2, U16.12, X1.2
unnamed: C39.2, U16.13, X1.1
unnamed: R44.2, R45.1, U16.34
unnamed: TP20.1, U16.57
unnamed: R91.1, U22.3
unnamed: C3.1, R126.2, U30.2
unnamed: R139.2, U30.3
unnamed: C74.1, L4.2, U30.1
unnamed: C265.1, R253.1, U31.2
unnamed: R133.2, U31.7
unnamed: R235.2, U31.6
unnamed: C262.2, C264.1, R248.1, U31.1
unnamed: C261.1, C263.2, R247.2, U31.8
unnamed: R138.1, U33.1
unnamed: C306.1, R384.2, U35.1
unnamed: C282.2, R201.1, R203.2, R212.2, U5.3, U38.2
unnamed: C282.1, C286.1, R204.2, R208.1, TP24.1, U38.1
unnamed: C4.1, R124.2, U40.2
unnamed: R140.2, U40.3
unnamed: C75.1, L5.2, U40.1
unnamed: D15.1, L1.1, U70.2
unnamed: R1291.1, U291.5
unnamed: TP1391.1, U291.20, U291.21, Z191.2, Z201.1
unnamed: C2391.1, R1411.1, U291.9, U301.8
unnamed: C2551.1, R1591.1, U291.8, U301.9
unnamed: C2481.1, R1511.1, U291.3
unnamed: C2561.2, C2691.2, U291.15
unnamed: C2451.1, R1461.1, U291.4
unnamed: C2441.1, R1451.1, U291.11, U301.11
unnamed: R1292.1, U292.5
unnamed: TP1392.1, U292.20, U292.21, Z192.2, Z202.1
unnamed: C2392.1, R1412.1, U292.9, U302.8
unnamed: C2552.1, R1592.1, U292.8, U302.9
unnamed: C2482.1, R1512.1, U292.3
unnamed: C2562.2, C2692.2, U292.15
unnamed: C2452.1, R1462.1, U292.4
unnamed: C2442.1, R1452.1, U292.11, U302.11
unnamed: R1293.1, U293.5
unnamed: TP1393.1, U293.20, U293.21, Z193.2, Z203.1
unnamed: C2393.1, R1413.1, U293.9, U303.8
unnamed: C2553.1, R1593.1, U293.8, U303.9
unnamed: C2483.1, R1513.1, U293.3
unnamed: C2563.2, C2693.2, U293.15
unnamed: C2453.1, R1463.1, U293.4
unnamed: C2443.1, R1453.1, U293.11, U303.11
unnamed: R1561.1, U301.5
unnamed: TP1491.1, U301.20, U301.21, Z231.2, Z241.1
unnamed: C2511.1, R1531.1, U301.3
unnamed: R1511.2, U301.2
unnamed: C2001.2, C2721.2, U301.15
unnamed: C2461.1, R1471.1, U301.4
unnamed: R1562.1, U302.5
unnamed: TP1492.1, U302.20, U302.21, Z232.2, Z242.1
unnamed: C2512.1, R1532.1, U302.3
unnamed: R1512.2, U302.2
unnamed: C2002.2, C2722.2, U302.15
unnamed: C2462.1, R1472.1, U302.4
unnamed: R1563.1, U303.5
unnamed: TP1493.1, U303.20, U303.21, Z233.2, Z243.1
unnamed: C2513.1, R1533.1, U303.3
unnamed: R1513.2, U303.2
unnamed: C2003.2, C2723.2, U303.15
unnamed: C2463.1, R1473.1, U303.4
OCURLIM_NEG: R22.2, U16.93
OCURLIM_POS: R21.2, U16.95
OCUR_IN: C2.1, R23.1, TP21.1, U3.1, U3.2, U3.13, U3.14, U14.3, U16.2
PRECHARGE_OUT: TP1.1, U16.36
PWM1_N: U11.3, U16.52
PWM1_P: U11.2, U16.67
PWM2_N: U11.5, U16.53
PWM2_P: U11.4, U16.68
PWM3_N: U11.7, U16.54
PWM3_P: U11.6, U16.69
PWM_INHIBIT: U14.4, U16.51
REVER_IN: D5.1, J1.4, R32.2
REV_IN: C30.1, R32.1, R34.2, U16.26
SINA: C60.1, J1.17, R111.1, R112.2
SINB: J1.7, R114.2
SPI1_MISO: U7.7, U16.90
SPI1_MOSI: U11.9, U16.91
SPI1_SCK: U11.8, U16.89
START: D19.1, J1.1, R35.2
START_IN: C31.1, R35.1, R37.2, U16.88
SWCLK: J3.3, U16.76
SWDAT: J3.1, U16.72
T15_IN: D3.1, J1.3, R7.2
T15_OUT: C1.1, R6.2, R7.1, R25.2, U16.25
THROTTLE1: C28.1, R29.1, R3000.2, U16.15
THROTTLE2: C27.1, R2007.1, R2008.2, U16.16
TMPHS1: C78.1, R128.1, ST1.2, U16.33
TMPHS2: C77.1, R129.1, ST3.2, U16.23
TMPHS3: C76.1, R130.1, ST4.2, U16.24
TMPM: C79.1, R132.1, U16.17
UDCIN: C82.1, R237.1, U1.1, U16.18
USART_RX: J4.3, U16.48
USART_TX: J4.4, U16.47
UVLO_IN: R40.2, U16.1
