dtmirizzi/Tesla-Model-3-Drive-Unit/(commit log)

2026-11-04 Add exact atopile port of the M3DU V3.2 logic board
    Flat, netlist-exact atopile 0.15.9 project generated from the KiCad V3.2
    design, with the original hand-routed layout carried over:
    - tools/extract_kicad.py: reference netlist + recovered footprint/symbol libs
    - tools/gen_ato.py: one component per BOM line, main.ato with all nets
    - tools/seed_layout.py: seed layouts/ with the original PCB (atopile_address)
    - tools/check_netlist.py: pad-level netlist + layout equivalence check (passes)
    - PLAN.md: roadmap for the modular refactor, CI, and findings
    Claude-Session: https://claude.ai/code/session_018mPram3Jk5weYuMD9sQQKH
    [default.kicad_pcb]
2026-11-04 atopile port: modular design, shared gate-driver phase, CI
    - tools/gen_modules.py: one module per titled schematic block (src/),
    typed ElectricPower rails, nets between blocks as ports
    - gate-driver phases proven identical by graph matching: one
    GateDrivePhase module instantiated 3x (phase C retypes TR6 only)
    - reference/addresses.json binds designators to the new addresses;
    seed_layout uses it with deterministic UUIDs
    - check_netlist passes; atopile BOM matches the JLC BOM (703 parts)
    - .github/workflows/atopile.yml: regenerate, build, equivalence check,
    stale-output check, KiCad 9 DRC report + fab outputs
    Claude-Session: http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
    [default.kicad_pcb]
2026-11-04 CI: run the equivalence checkers as explicit steps; pin net names
    - CI checks the committed board, rebuilds, re-checks netlist + layout,
    checks the BOM against the JLC BOM and fails on stale generated code;
    each checker writes a table to the GitHub job summary
    - tools/check_bom.py: per-designator LCSC comparison with the V3.2 JLC BOM
    - net names pinned with has_net_name_suggestion, so builds no longer need
    --keep-net-names (which failed whenever an edit split a net)
    - PLAN.md: editing round-trip results and what remains before the atopile
    project can be the active design
    Claude-Session: https://claude.ai/code/session_018mPram3J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
    [default.kicad_pcb]
2026-11-04 CI: run the KiCad container as root so it can write the workspace
    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
2026-11-04 CI: gate DRC on violations the atopile board adds to the original's
    The original V3.2 board is not DRC-clean (the first run found 32 errors on
    the atopile board), so DRC runs on both boards and tools/compare_drc.py
    fails only on new violations.
    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
2026-11-04 Fix the DRC regressions CI found; check full footprint and board content
    The first DRC gate run found 31 violations the original board does not
    have. Causes and fixes:
    - one library footprint per name lost per-instance content (courtyards,
    zone/clearance overrides, DNP): split variants by full content
    - KiCad project rules missing next to the atopile layout: copy .kicad_pro
    - atopile 0.15.9 drops footprint locked/clearance/zone_connect/groups, pad
    thermal_bridge_angle, item locks, and rewrites the stackup (ENIG, black
    mask): push overrides onto pads, and tools/restore_layout.py restores
    the rest after each build, only on footprints atopile left unchanged
    - check_netlist.py now compar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
    [default.kicad_pcb]
2026-11-04 CI: ship the KiCad project file (design rules) with the atopile board
    DRC in the fab job only got default.kicad_pcb, so it ran with KiCad's
    default rules and severities instead of the board's.
    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
2026-11-04 CI: compare Gerbers, drill and positions with the original board's
    Both boards are plotted by the same kicad-cli; tools/compare_fab.py fails
    on any difference outside metadata lines.
    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
2026-11-04 Restore text fields atopile blanks; compare fab output as geometry
    - atopile writes an empty Value (visible on F.Fab) and fills other fields
    from symbol defaults; restore_layout.py restores the original fields on
    unchanged parts and shows the new part number on changed ones
    - check_netlist.py now also requires every original text field to survive
    - compare_fab.py compares Gerber geometry (draws, arcs, flashes, regions
    per polarity block) and drill hits per tool, independent of plot order,
    aperture numbering and X2 metadata
    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
    [default.kicad_pcb]
